davisim2/BP/KiCad_soubory/AS5304A.pdf

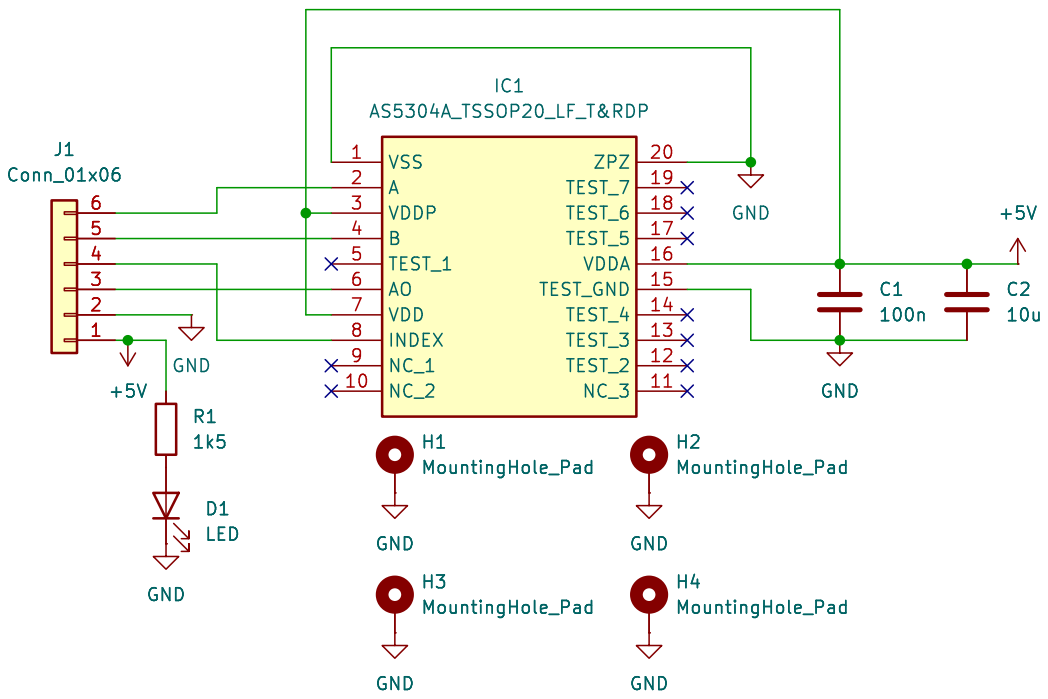
[picture p1: page 1]

Id: 1/1 Title: File: AS5304A.kicad_sch Sheet: / H4 MountingHole_Pad D1
