davisim2/BP/KiCad_soubory/BP Nerf Blaster.pdf

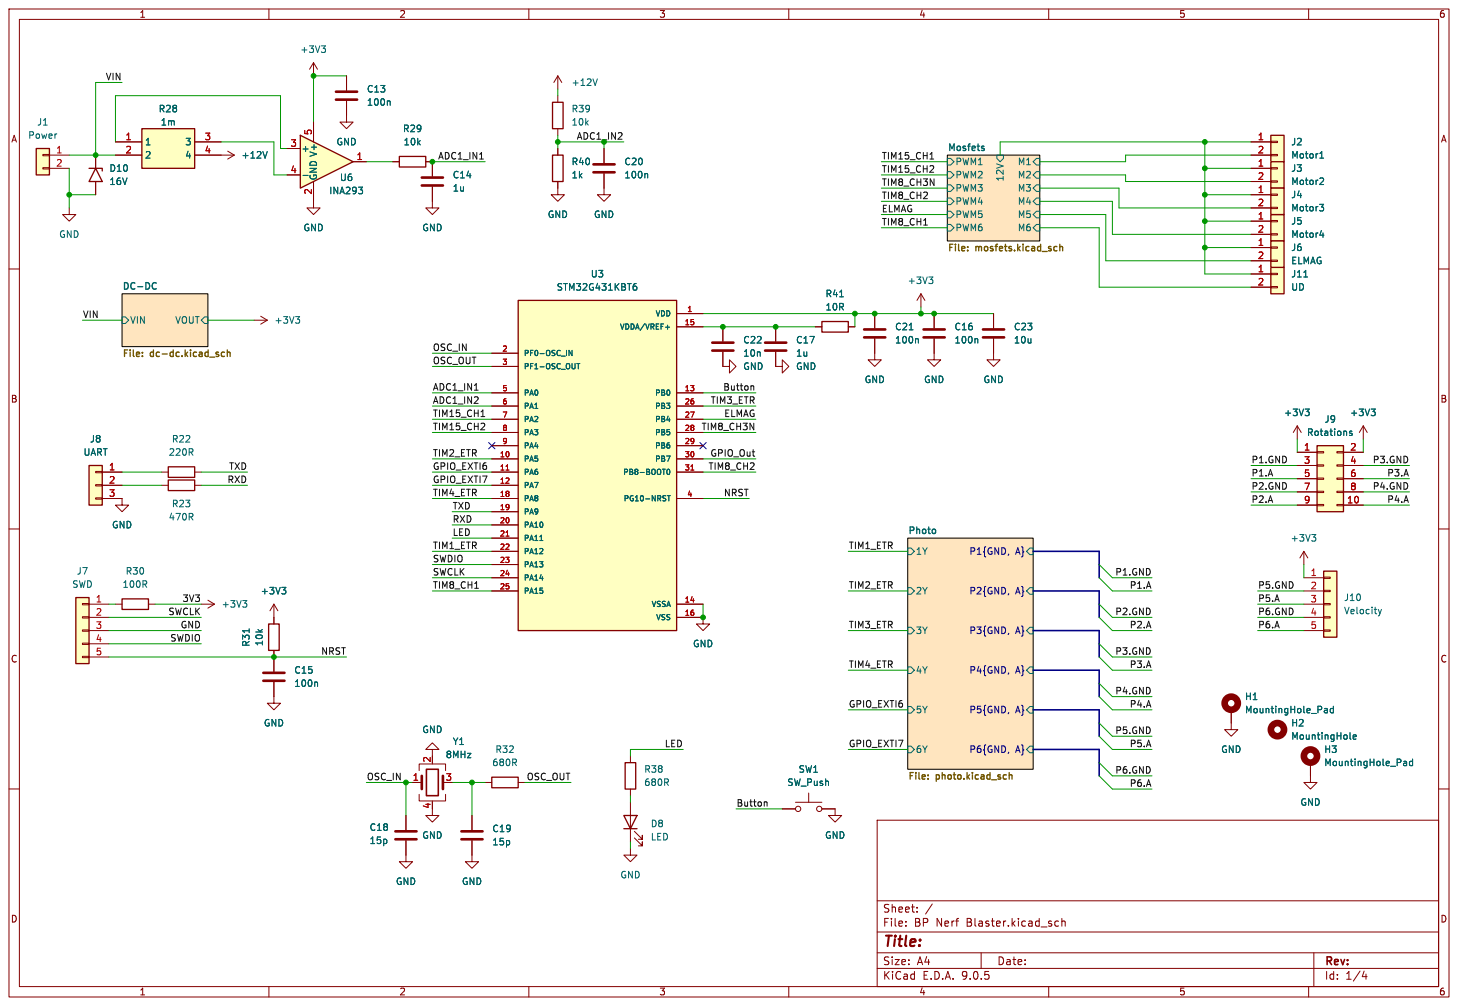
[picture p2: page 1]

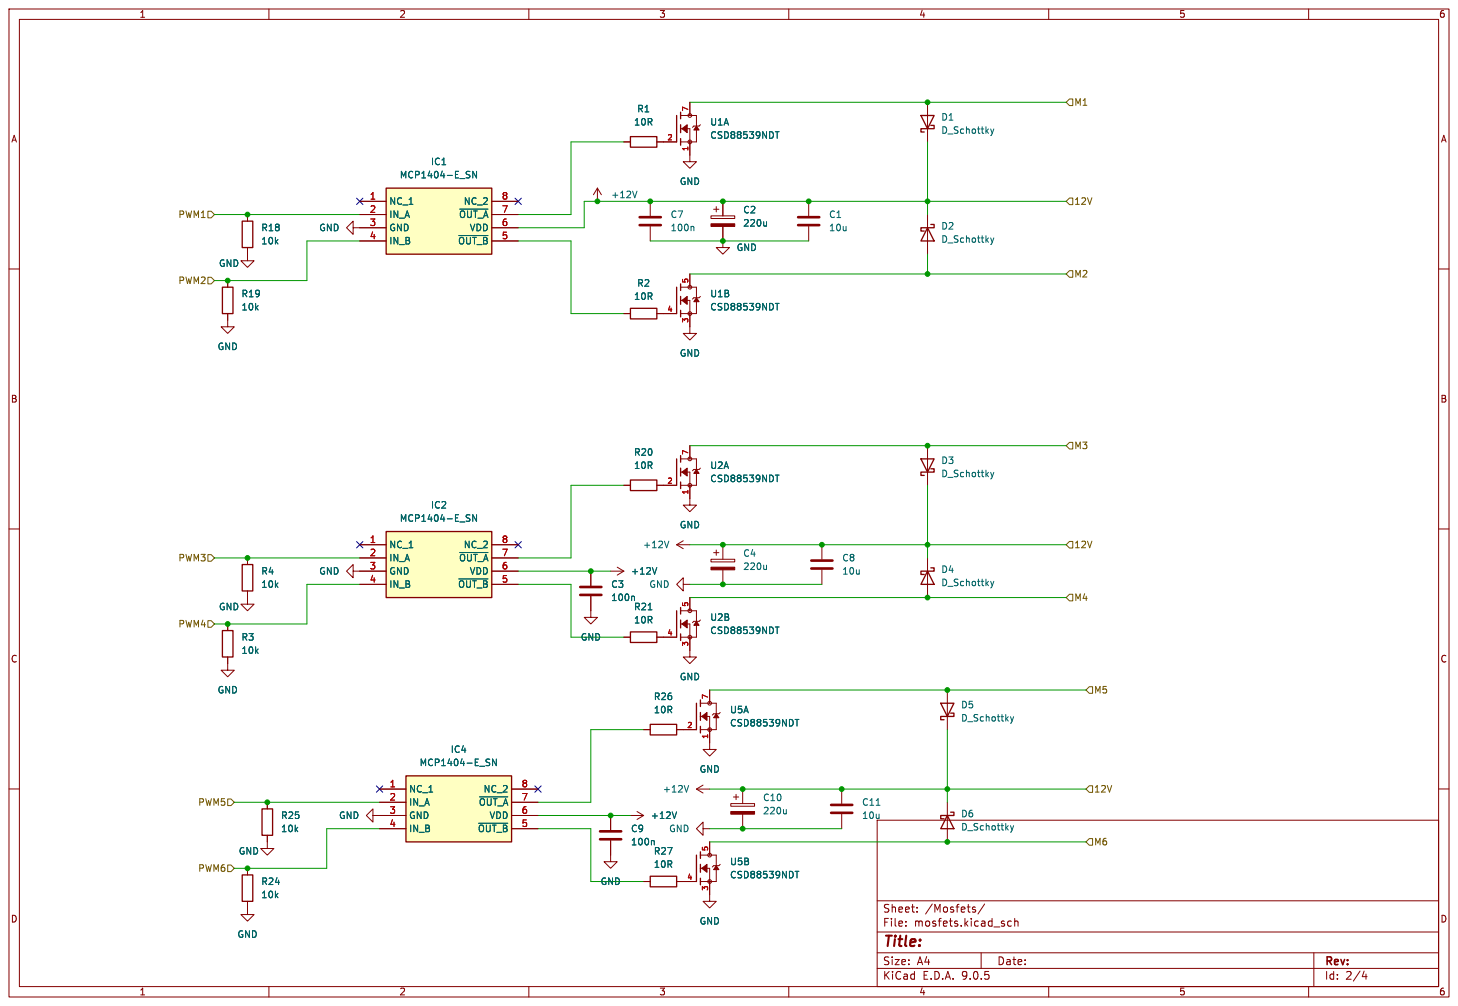
[picture p3: page 2]

Id: 2/4 Title: File: mosfets.kicad_sch Sheet: /Mosfets/ R26

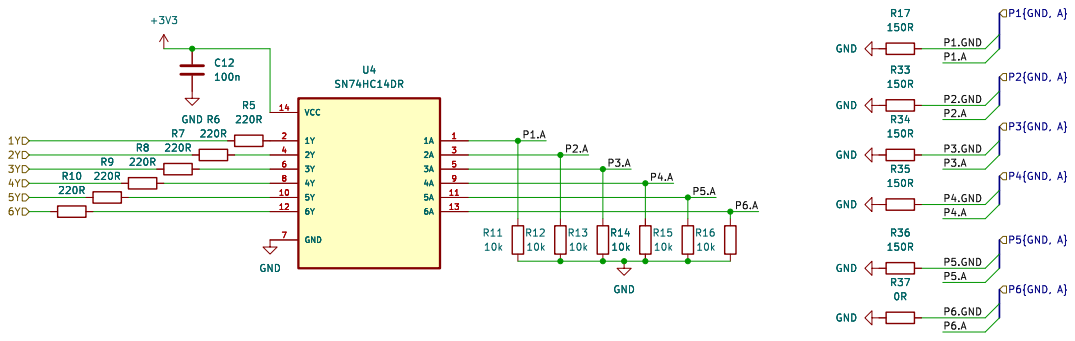
[picture p4: page 3]

Id: 3/4 Title: File: photo.kicad_sch Sheet: /Photo/

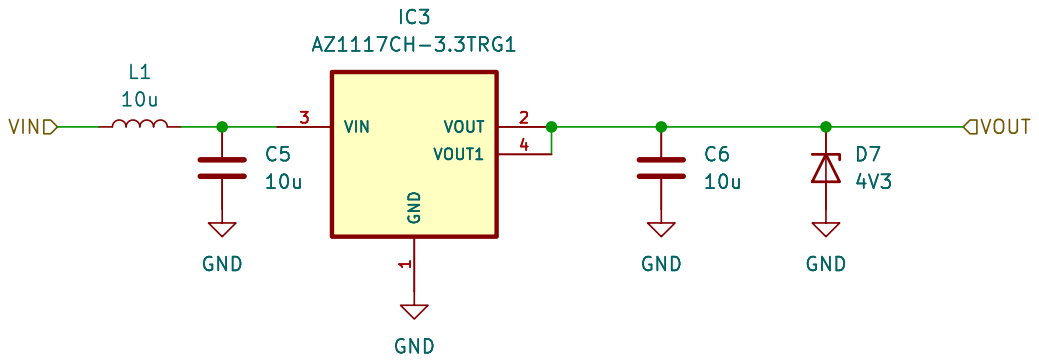
[picture p5: page 4]

Id: 4/4 Title: File: dc-dc.kicad_sch Sheet: /DC-DC/ GND
