davisim2/BP/KiCad_soubory/Fotodiody.pdf

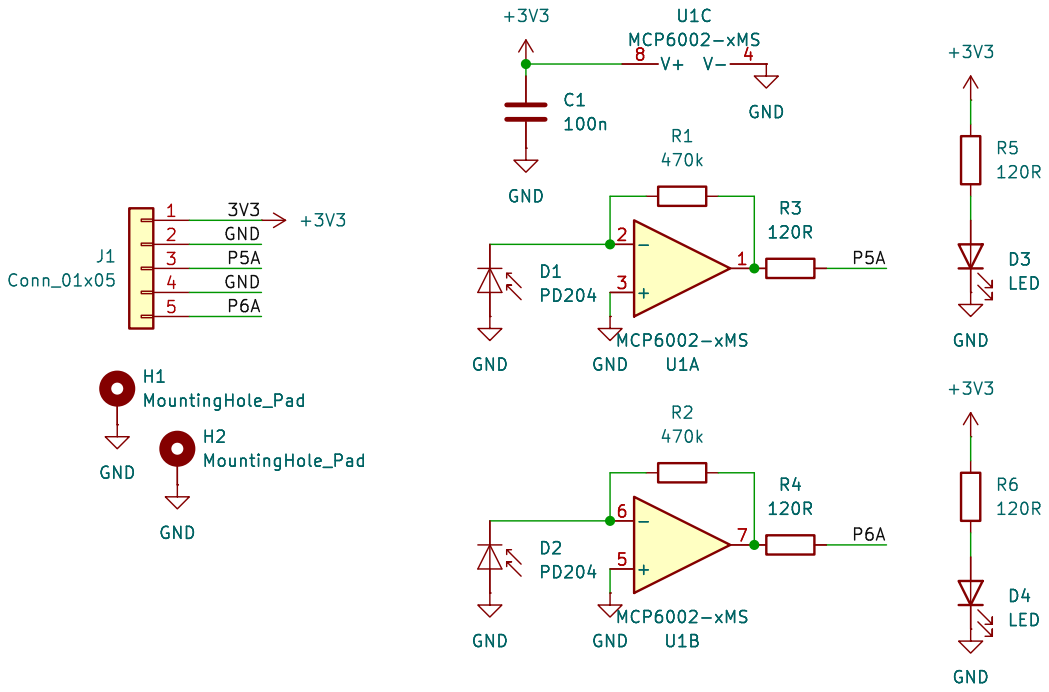
[picture p6: page 1]

Id: 1/1 Title: File: Fotodiody.kicad_sch Sheet: /
