davisim2/BP/KiCad_soubory/Řídící plošňák.pdf

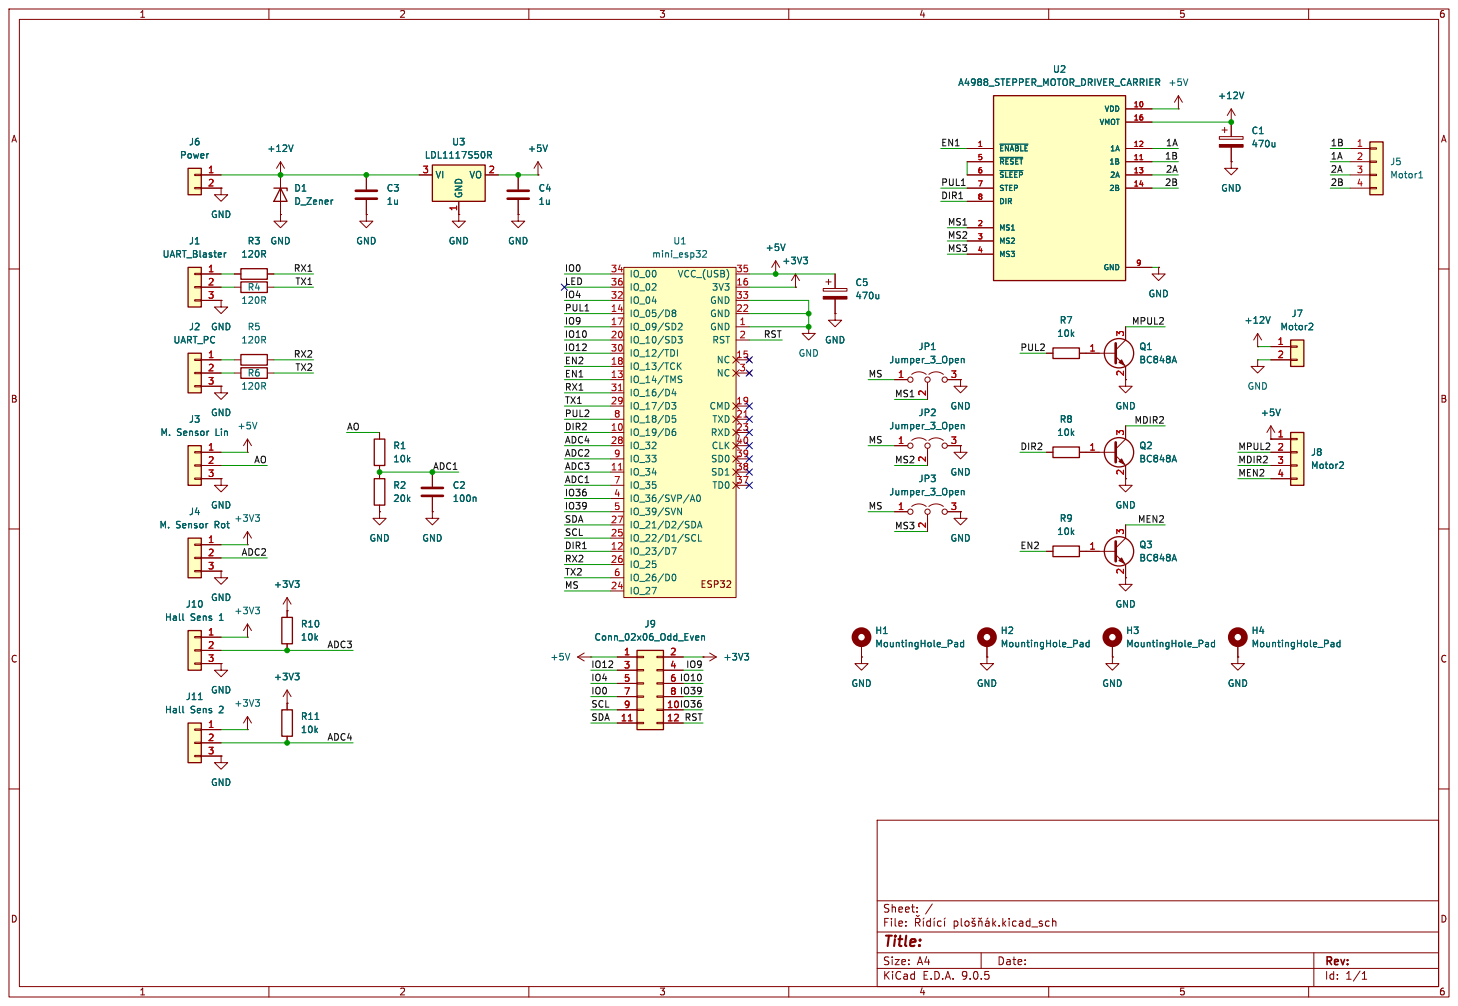
[picture p7: page 1]
