davisim2/BP/KiCad_soubory/BP Nerf Blaster/BP Nerf Blaster.kicad_pcb

## KiCad design KiCad_soubory/BP Nerf Blaster/BP Nerf Blaster.kicad_pcb (2026-05-22)

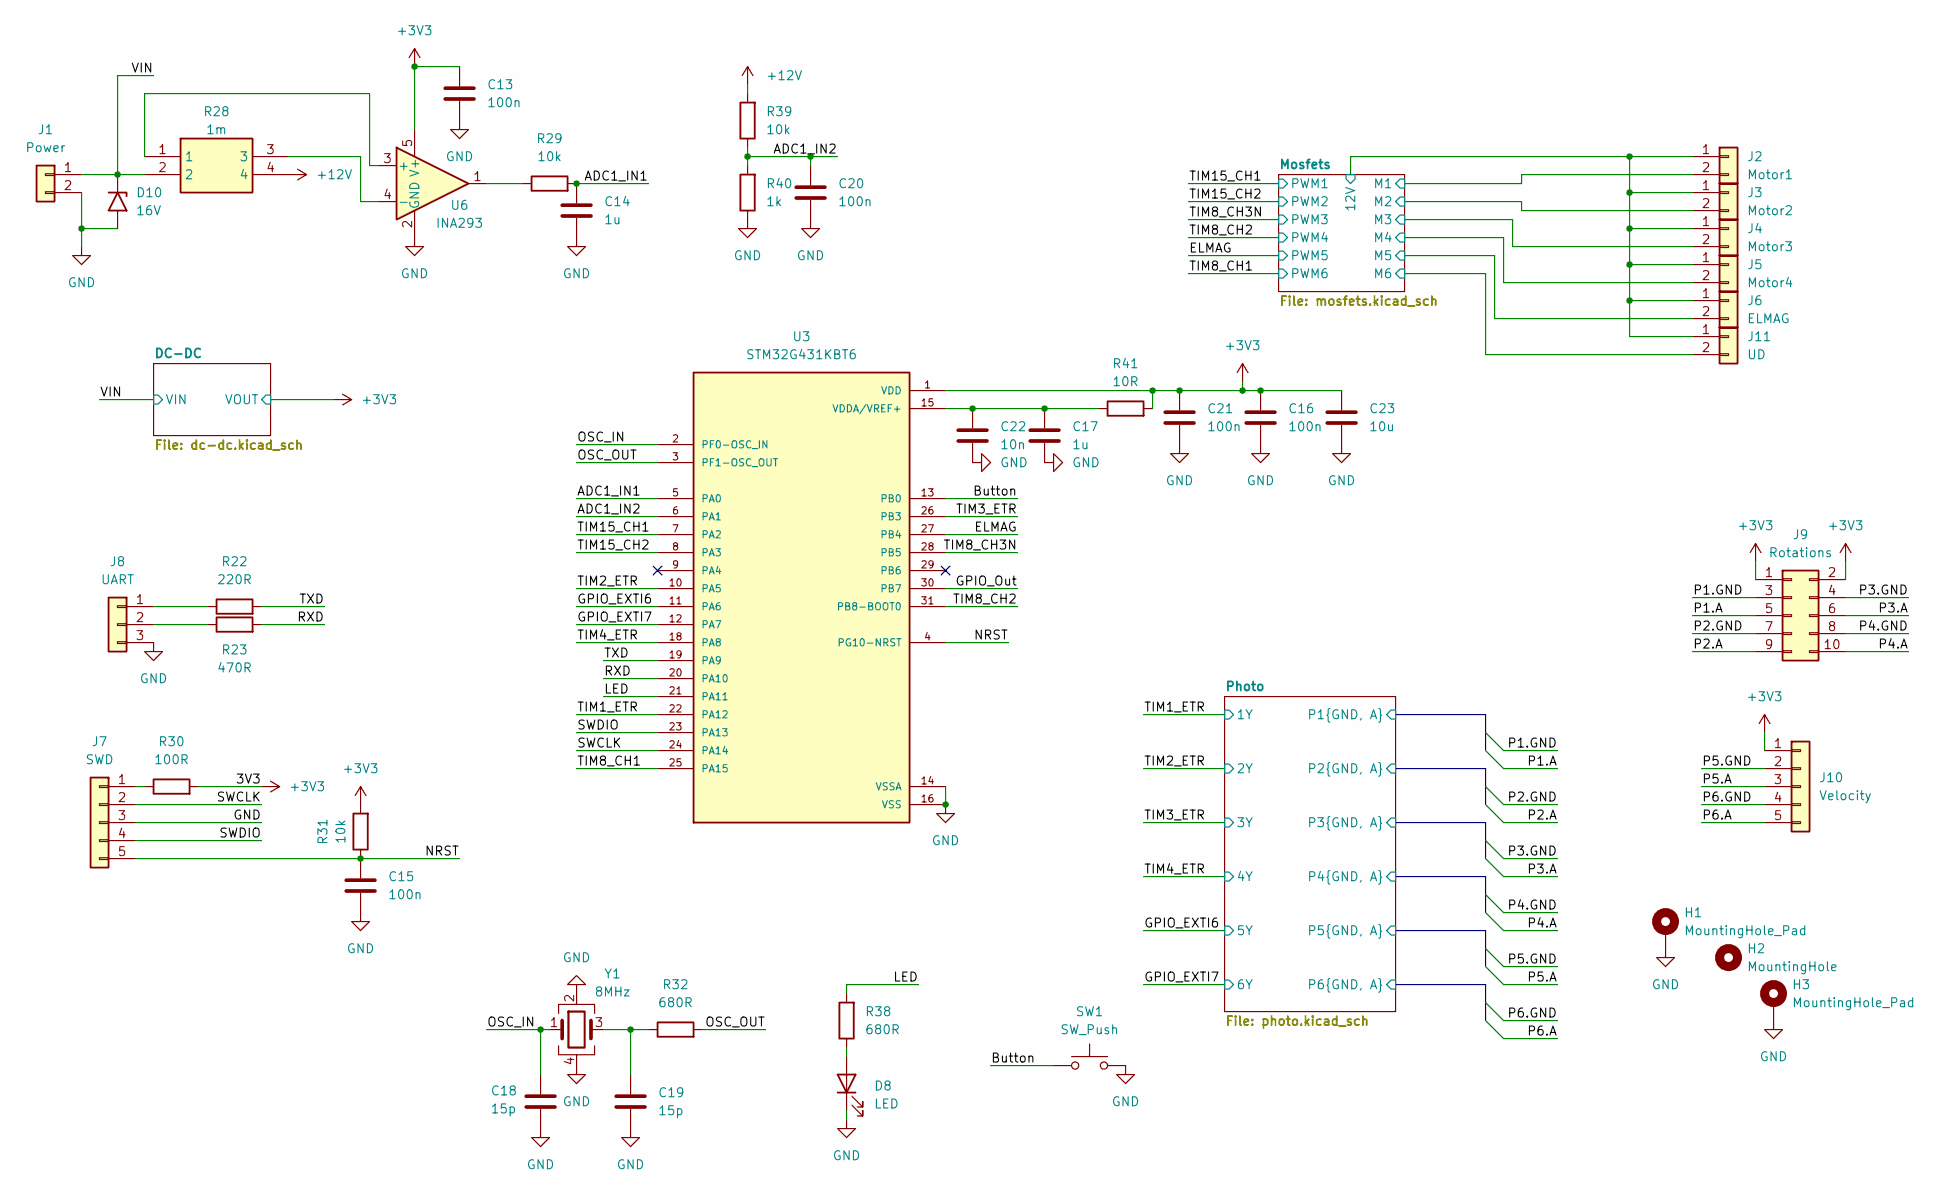
[picture p8: schematic BP Nerf Blaster.kicad_sch]

Parts:
C13, C15, C16, C20, C21: 100n; C_0805_2012Metric
C14, C17: 1u; C_0805_2012Metric
C18, C19: 15p; C_0805_2012Metric
C22: 10n; C_0603_1608Metric_Pad1.08x0.95mm_HandSolder
C23: 10u; C_0805_2012Metric
D8: LED; LED_D3.0mm
D10: 16V; D_SMB
H1, H3: MountingHole_Pad; MountingHole_3.2mm_M3_DIN965_Pad
H2: MountingHole; Hole
J1: Power; XT30-f
J2: Motor1; XT30-f
J3: Motor2; XT30-f
J4: Motor3; XT30-f
J5: Motor4; XT30-f
J6: ELMAG; XT30-f
J7: SWD; PinHeader_1x05_P1.27mm_Vertical
J8: UART; PinHeader_1x03_P2.54mm_Vertical
J9: Rotations; PinHeader_2x05_P2.54mm_Vertical
J10: Velocity; PinHeader_1x05_P2.54mm_Vertical
J11: UD; XT30-f
R22: 220R; R_0805_2012Metric
R23: 470R; R_0805_2012Metric
R28: 1m; WSK25121L000FEA; Mouser Part Number 71-WSK25121L000FEA
R29, R31, R39: 10k; R_0805_2012Metric
R30: 100R; R_0805_2012Metric
R32, R38: 680R; R_0805_2012Metric
R40: 1k; R_0805_2012Metric
R41: 10R; R_0805_2012Metric
SW1: SW_Push; SW_PUSH_6mm_H9.5mm
U3: STM32G431KBT6; QFP80P900X900X160-32N; PARTREV 2
U6: INA293; SOT-23-5
Y1: 8MHz; Crystal_SMD_SeikoEpson_FA238-4Pin_3.2x2.5mm

Connections:
+3V3: C13.1, C16.1, C21.1, C23.1, J9.1, J9.2, J10.1, R30.2, R31.2, R41.2, U3.1 (VDD), U3.17 (VDD), U6.5 (V+); also elsewhere on the board
+12V: J2.1, J3.1, J4.1, J5.1, J6.1, J11.1, R28.4, R39.2; also elsewhere on the board
/ADC1_IN1: C14.1, R29.2, U3.5 (PA0)
/ADC1_IN2: C20.1, R39.1, R40.2, U3.6 (PA1)
/Button: SW1.1, U3.13 (PB0)
/ELMAG: U3.27 (PB4); also elsewhere on the board
/GPIO_EXTI6: U3.11 (PA6); also elsewhere on the board
/GPIO_EXTI7: U3.12 (PA7); also elsewhere on the board
/GPIO_Out: U3.30 (PB7)
/LED: R38.2, U3.21 (PA11)
/Mosfets/M1: J2.2; also elsewhere on the board
/Mosfets/M2: J3.2; also elsewhere on the board
/Mosfets/M3: J4.2; also elsewhere on the board
/Mosfets/M4: J5.2; also elsewhere on the board
/Mosfets/M5: J6.2; also elsewhere on the board
/Mosfets/M6: J11.2; also elsewhere on the board
/NRST: C15.1, J7.5, R31.1, U3.4 (PG10-NRST)
/OSC_IN: C18.1, U3.2 (PF0-OSC_IN), Y1.1
/OSC_OUT: R32.2, U3.3 (PF1-OSC_OUT)
/Photo/P1.A: J9.5; also elsewhere on the board
/Photo/P1.GND: J9.3; also elsewhere on the board
/Photo/P2.A: J9.9; also elsewhere on the board
/Photo/P2.GND: J9.7; also elsewhere on the board
/Photo/P3.A: J9.6; also elsewhere on the board
/Photo/P3.GND: J9.4; also elsewhere on the board
/Photo/P4.A: J9.10; also elsewhere on the board
/Photo/P4.GND: J9.8; also elsewhere on the board
/Photo/P5.A: J10.3; also elsewhere on the board
/Photo/P5.GND: J10.2; also elsewhere on the board
/Photo/P6.A: J10.5; also elsewhere on the board
/RXD: R23.2, U3.20 (PA10)
/SWCLK: J7.2, U3.24 (PA14)
/SWDIO: J7.4, U3.23 (PA13)
/TIM1_ETR: U3.22 (PA12); also elsewhere on the board
/TIM2_ETR: U3.10 (PA5); also elsewhere on the board
/TIM3_ETR: U3.26 (PB3); also elsewhere on the board
/TIM4_ETR: U3.18 (PA8); also elsewhere on the board
/TIM8_CH1: U3.25 (PA15); also elsewhere on the board
/TIM8_CH2: U3.31 (PB8-BOOT0); also elsewhere on the board
/TIM8_CH3N: U3.28 (PB5); also elsewhere on the board
/TIM15_CH1: U3.7 (PA2); also elsewhere on the board
/TIM15_CH2: U3.8 (PA3); also elsewhere on the board
/TXD: R22.2, U3.19 (PA9)
/VIN: D10.1 (A1), J1.1, R28.2; also elsewhere on the board
unnamed: C19.1, R32.1, Y1.3
unnamed: D8.2 (A), R38.1
unnamed: J7.1, R30.1
unnamed: J8.1, R22.1
unnamed: J8.2, R23.1
unnamed: R29.1, U6.1
unnamed: C17.1, C22.1, R41.1, U3.15 (VDDA/VREF+)
unnamed: R28.1, U6.3 (+)
unnamed: R28.3, U6.4 (-)

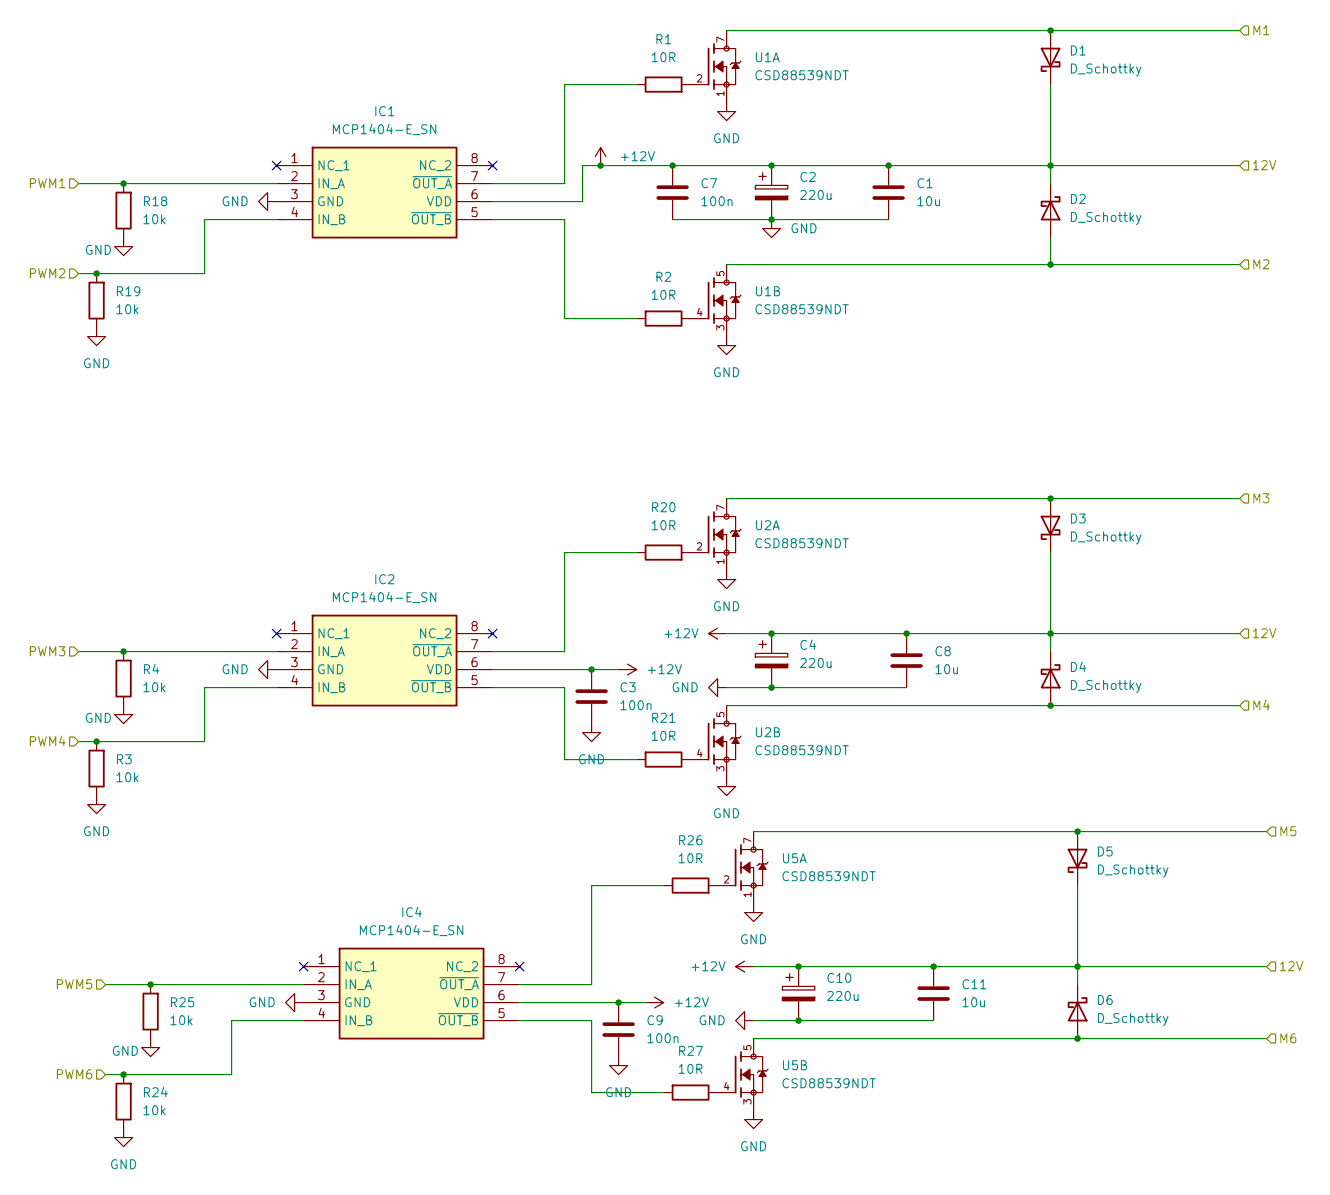
[picture p9: schematic mosfets.kicad_sch]

Parts:
C1, C8, C11: 10u; C_1206_3216Metric
C2, C4: 220u; C_Elec_8x10.2
C3, C7, C9: 100n; C_0805_2012Metric
C10: 220u; C_Elec_8x10.2; Mouser 80-EEV227M025A9MAA
D1: D_Schottky; D_SMA; Mouser 625-SSA34-E3
D2, D3, D4, D5, D6: D_Schottky; D_SMA
IC1, IC2, IC4: MCP1404-E_SN; SOIC127P600X175-8N; Mouser Part Number 579-MCP1404-E/SN
R1, R2, R20, R21, R26, R27: 10R; R_0805_2012Metric
R3, R4, R18, R19, R24, R25: 10k; R_0805_2012Metric
U1, U2, U5: CSD88539NDT; SOIC127P600X175-8N; PARTREV February 2014

Connections:
+12V: C1.1, C2.1, C3.1, C4.1, C7.1, C8.1, C9.1, C10.1, C11.1, D1.1 (K), D2.1 (K), D3.1 (K), D4.1 (K), D5.1 (K), D6.1 (K), IC1.6 (VDD), IC2.6 (VDD), IC4.6 (VDD); also elsewhere on the board
/ELMAG: IC4.2 (IN_A), R25.2; also elsewhere on the board
/Mosfets/M1: D1.2 (A), U1.7, U1.8; also elsewhere on the board
/Mosfets/M2: D2.2 (A), U1.5, U1.6; also elsewhere on the board
/Mosfets/M3: D3.2 (A), U2.7, U2.8; also elsewhere on the board
/Mosfets/M4: D4.2 (A), U2.5, U2.6; also elsewhere on the board
/Mosfets/M5: D5.2 (A), U5.7, U5.8; also elsewhere on the board
/Mosfets/M6: D6.2 (A), U5.5, U5.6; also elsewhere on the board
/TIM8_CH1: IC4.4 (IN_B), R24.2; also elsewhere on the board
/TIM8_CH2: IC2.4 (IN_B), R3.2; also elsewhere on the board
/TIM8_CH3N: IC2.2 (IN_A), R4.2; also elsewhere on the board
/TIM15_CH1: IC1.2 (IN_A), R18.2; also elsewhere on the board
/TIM15_CH2: IC1.4 (IN_B), R19.2; also elsewhere on the board
unnamed: IC1.7 (~OUT_A), R1.1
unnamed: IC1.5 (~OUT_B), R2.2
unnamed: IC2.7 (~OUT_A), R20.1
unnamed: IC2.5 (~OUT_B), R21.2
unnamed: IC4.7 (~OUT_A), R26.1
unnamed: IC4.5 (~OUT_B), R27.2
unnamed: R1.2, U1.2
unnamed: R2.1, U1.4
unnamed: R20.2, U2.2
unnamed: R21.1, U2.4
unnamed: R26.2, U5.2
unnamed: R27.1, U5.4

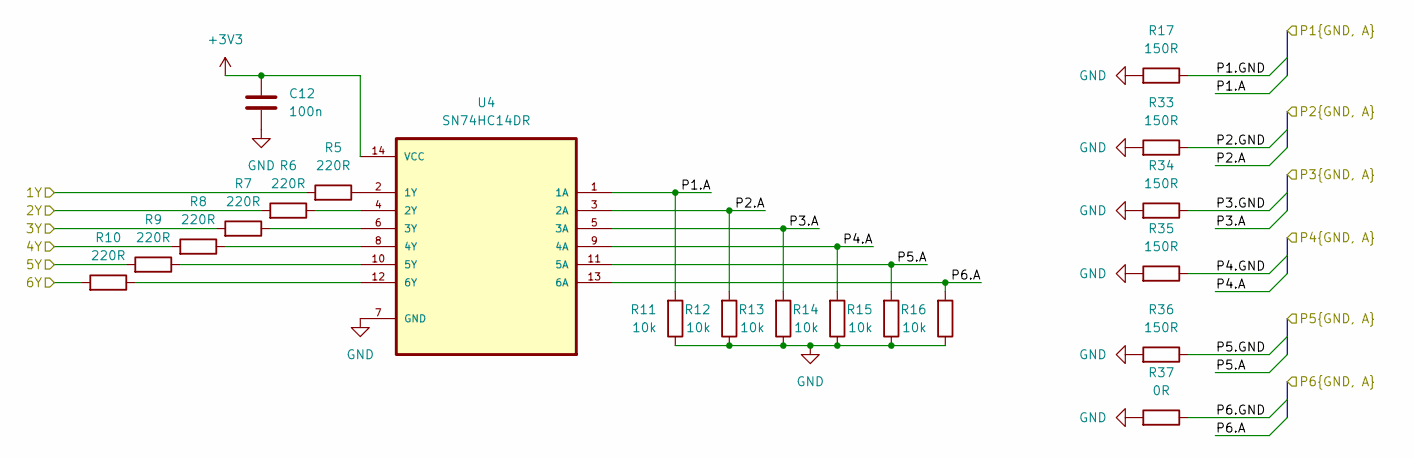
[picture p10: schematic photo.kicad_sch]

Parts:
C12: 100n; C_0805_2012Metric
R5, R6, R7, R8, R9, R10: 220R; R_0805_2012Metric
R11, R12, R13, R14, R15, R16: 10k; R_0805_2012Metric
R17, R33, R34, R35, R36: 150R; R_0805_2012Metric
R37: 0R; R_0805_2012Metric
U4: SN74HC14DR; SOIC127P600X175-14N

Connections:
+3V3: C12.1, U4.14 (VCC); also elsewhere on the board
/GPIO_EXTI6: R9.2; also elsewhere on the board
/GPIO_EXTI7: R10.2; also elsewhere on the board
/Photo/P1.A: R11.2, U4.1 (1A); also elsewhere on the board
/Photo/P1.GND: R17.1; also elsewhere on the board
/Photo/P2.A: R12.2, U4.3 (2A); also elsewhere on the board
/Photo/P2.GND: R33.1; also elsewhere on the board
/Photo/P3.A: R13.2, U4.5 (3A); also elsewhere on the board
/Photo/P3.GND: R34.1; also elsewhere on the board
/Photo/P4.A: R14.2, U4.9 (4A); also elsewhere on the board
/Photo/P4.GND: R35.1; also elsewhere on the board
/Photo/P5.A: R15.2, U4.11 (5A); also elsewhere on the board
/Photo/P5.GND: R36.1; also elsewhere on the board
/Photo/P6.A: R16.2, U4.13 (6A); also elsewhere on the board
/Photo/P6.GND: R37.1
/TIM1_ETR: R5.2; also elsewhere on the board
/TIM2_ETR: R6.2; also elsewhere on the board
/TIM3_ETR: R7.2; also elsewhere on the board
/TIM4_ETR: R8.2; also elsewhere on the board
unnamed: R5.1, U4.2 (1Y)
unnamed: R6.1, U4.4 (2Y)
unnamed: R7.1, U4.6 (3Y)
unnamed: R8.1, U4.8 (4Y)
unnamed: R9.1, U4.10 (5Y)
unnamed: R10.1, U4.12 (6Y)

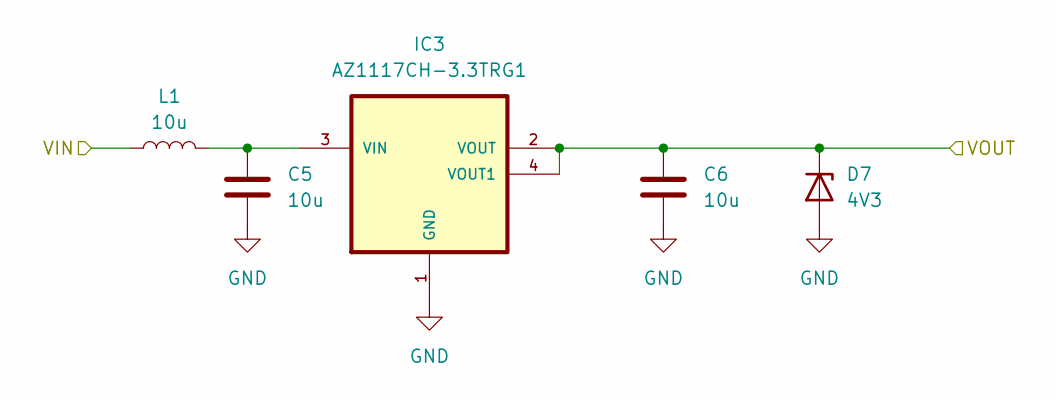
[picture p11: schematic dc-dc.kicad_sch]

Parts:
C5, C6: 10u; C_1206_3216Metric
D7: 4V3; D_SMA
IC3: AZ1117CH-3.3TRG1; SOT223
L1: 10u; L_0805_2012Metric

Connections:
+3V3: C6.1, D7.1 (K), IC3.2 (VOUT), IC3.4 (VOUT1); also elsewhere on the board
/VIN: L1.1; also elsewhere on the board
unnamed: C5.1, IC3.3 (VIN), L1.2

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
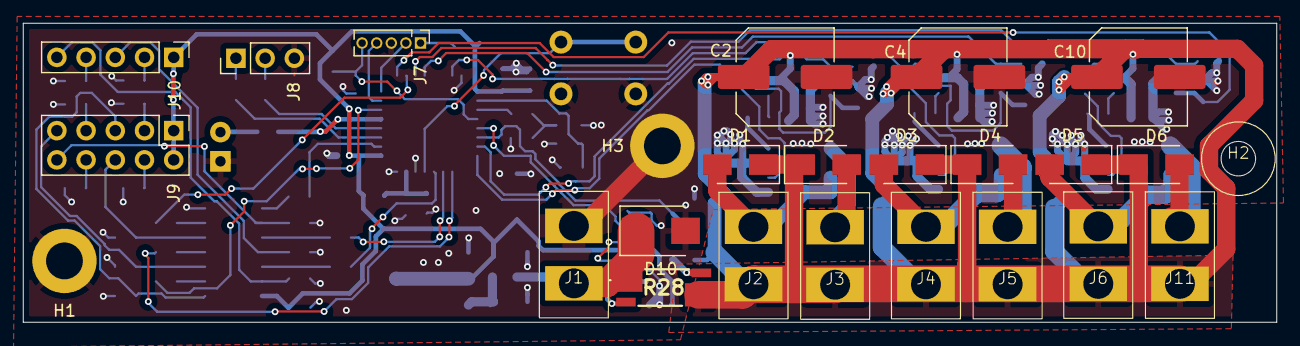
[picture p12: board BP Nerf Blaster.kicad_pcb from above]

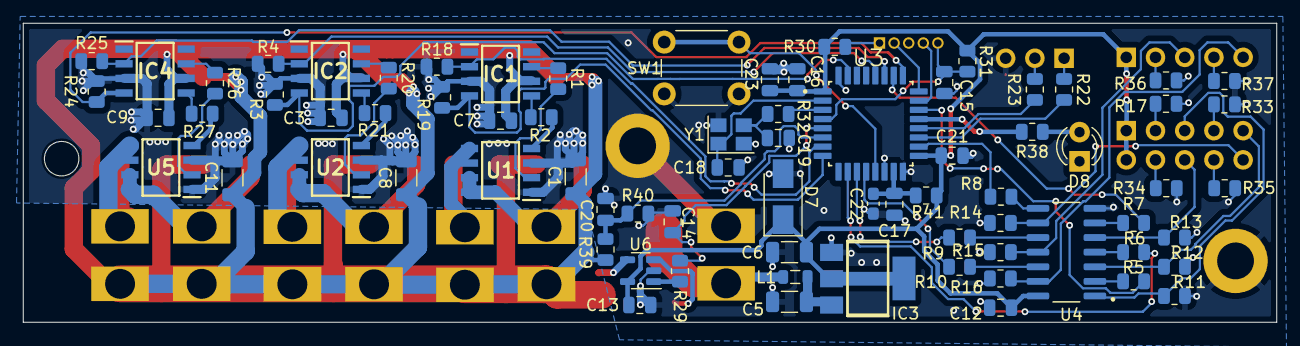
[picture p13: board BP Nerf Blaster.kicad_pcb from below]

Board: 2 copper layers, 109.0 x 26.0 mm, 100 parts (75 on the bottom side), 72 nets.
