davisim2/BP/KiCad_soubory/Řídící plošňák/Řídící plošňák.kicad_pcb

## KiCad design KiCad_soubory/Řídící plošňák/Řídící plošňák.kicad_pcb (2026-05-22)

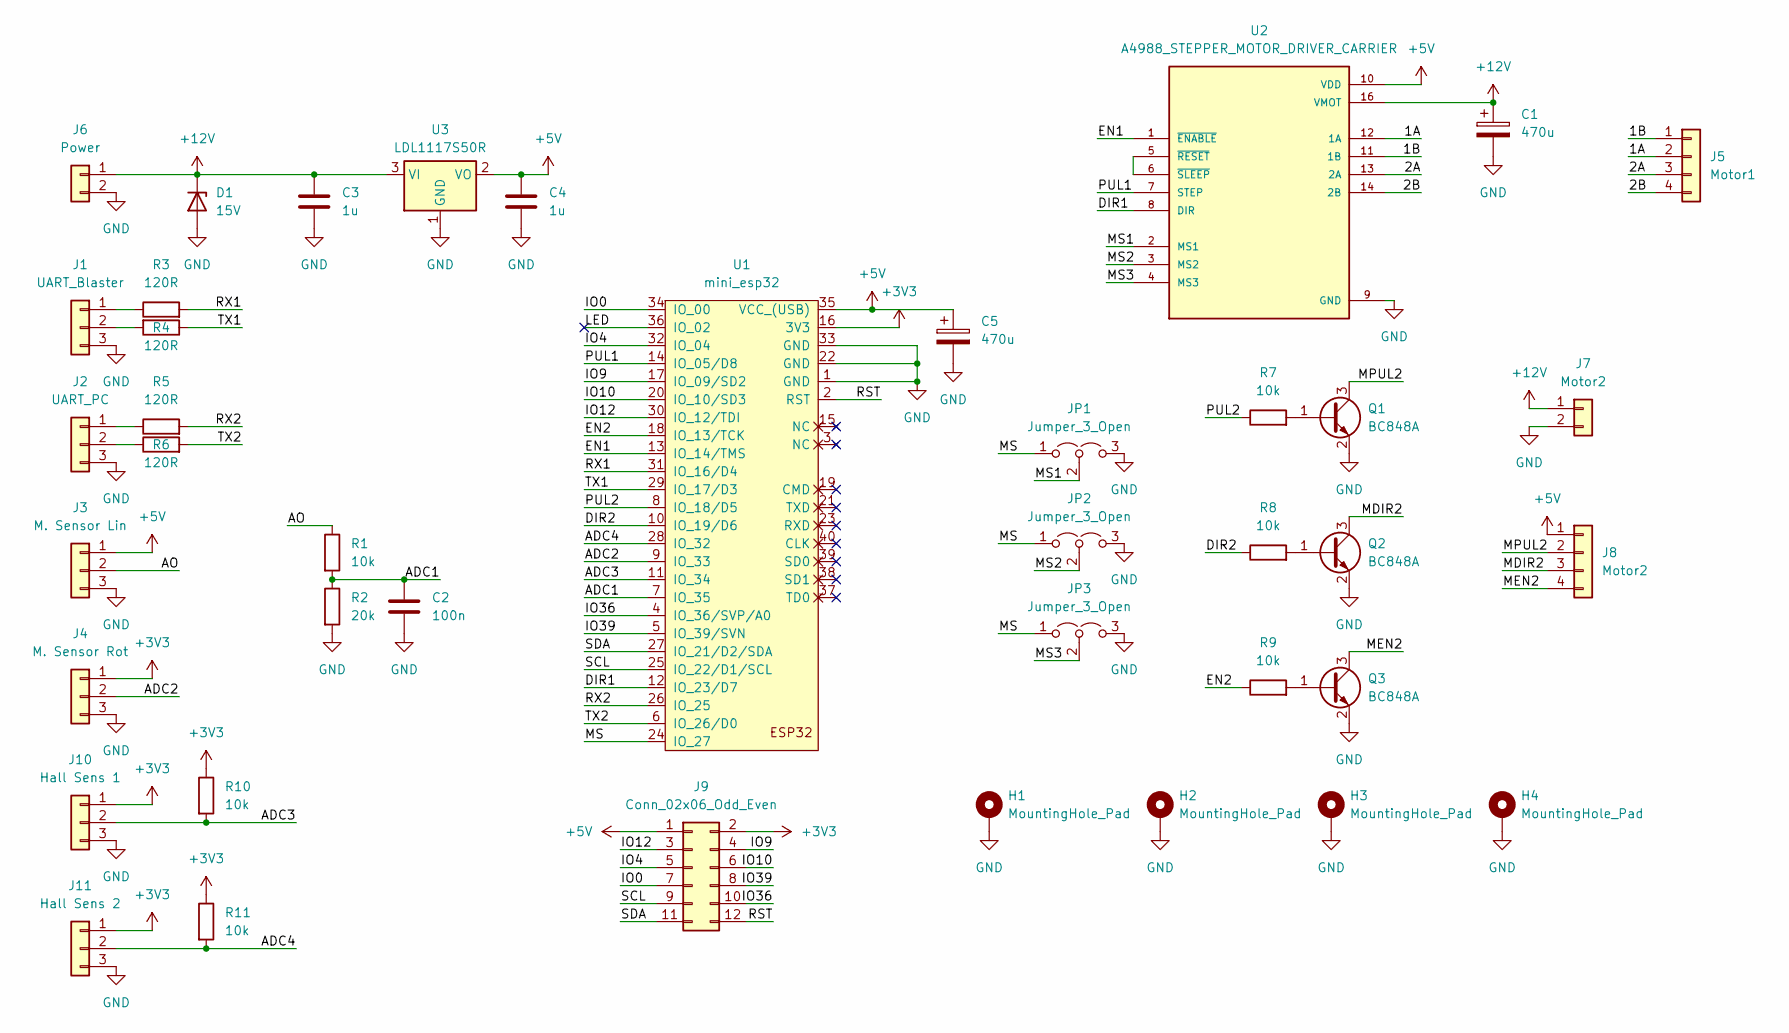
[picture p14: schematic Řídící plošňák.kicad_sch]

Parts:
C1, C5: 470u; CP_Elec_8x10
C2: 100n; C_1206_3216Metric_Pad1.33x1.80mm_HandSolder
C3, C4: 1u; C_1206_3216Metric_Pad1.33x1.80mm_HandSolder
D1: 15V; D_SMB_Handsoldering
H1, H2, H3, H4: MountingHole_Pad; MountingHole_4.3mm_M4_DIN965_Pad
J1: UART_Blaster; PinHeader_1x03_P2.54mm_Vertical
J2: UART_PC; PinHeader_1x03_P2.54mm_Vertical
J3: M. Sensor Lin; PinHeader_1x03_P2.54mm_Vertical
J4: M. Sensor Rot; PinHeader_1x03_P2.54mm_Vertical
J5: Motor1; TE_282822-4
J6: Power; XT30-f
J7: Motor2; XT30-f
J8: Motor2; PinHeader_1x04_P2.54mm_Vertical
J9: Conn_02x06_Odd_Even; PinHeader_2x06_P2.54mm_Vertical
J10: Hall Sens 1; PinHeader_1x03_P2.54mm_Vertical
J11: Hall Sens 2; PinHeader_1x03_P2.54mm_Vertical
JP1, JP2, JP3: Jumper_3_Open; SolderJumper-3_P1.3mm_Open_Pad1.0x1.5mm_NumberLabels
Q1, Q2, Q3: BC848A; SOT-23_Handsoldering
R1, R7, R8, R9, R10, R11: 10k; R_1206_3216Metric_Pad1.30x1.75mm_HandSolder
R2: 20k; R_1206_3216Metric_Pad1.30x1.75mm_HandSolder
R3, R4, R5, R6: 120R; R_1206_3216Metric_Pad1.30x1.75mm_HandSolder
U1: mini_esp32; ESP32_mini
U2: A4988_STEPPER_MOTOR_DRIVER_CARRIER; MODULE_A4988_STEPPER_MOTOR_DRIVER_CARRIER
U3: LDL1117S50R; SOT-223-3_TabPin2

Connections:
+3V3: J4.1, J9.2, J10.1, J11.1, R10.1, R11.1, U1.16 (3V3)
+5V: C4.1, C5.1, J3.1, J8.1, J9.1, U1.35 (VCC_(USB)), U2.10 (VDD), U3.2 (VO)
+12V: C1.1, C3.1, D1.1 (K), J6.1, J7.1, U2.16 (VMOT), U3.3 (VI)
/1A: J5.2, U2.12 (1A)
/1B: J5.1, U2.11 (1B)
/2A: J5.3, U2.13 (2A)
/2B: J5.4, U2.14 (2B)
/ADC1: C2.1, R1.2, R2.1, U1.7 (IO_35)
/ADC2: J4.2, U1.9 (IO_33)
/ADC3: J10.2, R10.2, U1.11 (IO_34)
/ADC4: J11.2, R11.2, U1.28 (IO_32)
/AO: J3.2, R1.1
/DIR1: U1.12 (IO_23/D7), U2.8 (DIR)
/DIR2: R8.1, U1.10 (IO_19/D6)
/EN1: U1.13 (IO_14/TMS), U2.1 (~ENABLE)
/EN2: R9.1, U1.18 (IO_13/TCK)
/IO0: J9.7, U1.34 (IO_00)
/IO4: J9.5, U1.32 (IO_04)
/IO9: J9.4, U1.17 (IO_09/SD2)
/IO10: J9.6, U1.20 (IO_10/SD3)
/IO12: J9.3, U1.30 (IO_12/TDI)
/IO36: J9.10, U1.4 (IO_36/SVP/A0)
/IO39: J9.8, U1.5 (IO_39/SVN)
/LED: U1.36 (IO_02)
/MDIR2: J8.3, Q2.3 (C)
/MEN2: J8.4, Q3.3 (C)
/MPUL2: J8.2, Q1.3 (C)
/MS: JP1.1 (A), JP2.1 (A), JP3.1 (A), U1.24 (IO_27)
/MS1: JP1.2 (C), U2.2 (MS1)
/MS2: JP2.2 (C), U2.3 (MS2)
/MS3: JP3.2 (C), U2.4 (MS3)
/PUL1: U1.14 (IO_05/D8), U2.7 (STEP)
/PUL2: R7.1, U1.8 (IO_18/D5)
/RST: J9.12, U1.2 (RST)
/RX1: R3.2, U1.31 (IO_16/D4)
/RX2: R5.2, U1.26 (IO_25)
/SCL: J9.9, U1.25 (IO_22/D1/SCL)
/SDA: J9.11, U1.27 (IO_21/D2/SDA)
/TX1: R4.1, U1.29 (IO_17/D3)
/TX2: R6.2, U1.6 (IO_26/D0)
GND: C1.2, C2.2, C3.2, C4.2, C5.2, D1.2 (A), H1.1, H2.1, H3.1, H4.1, J1.3, J2.3, J3.3, J4.3, J6.2, J7.2, J10.3, J11.3, JP1.3 (B), JP2.3 (B), JP3.3 (B), Q1.2 (E), Q2.2 (E), Q3.2 (E), R2.2, U1.1 (GND), U1.22 (GND), U1.33 (GND), U2.9 (GND), U2.15 (GND), U3.1 (GND)
unnamed: J1.1, R3.1
unnamed: J1.2, R4.2
unnamed: J2.1, R5.1
unnamed: J2.2, R6.1
unnamed: Q1.1 (B), R7.2
unnamed: Q2.1 (B), R8.2
unnamed: Q3.1 (B), R9.2
unnamed: U2.5 (~RESET), U2.6 (~SLEEP)

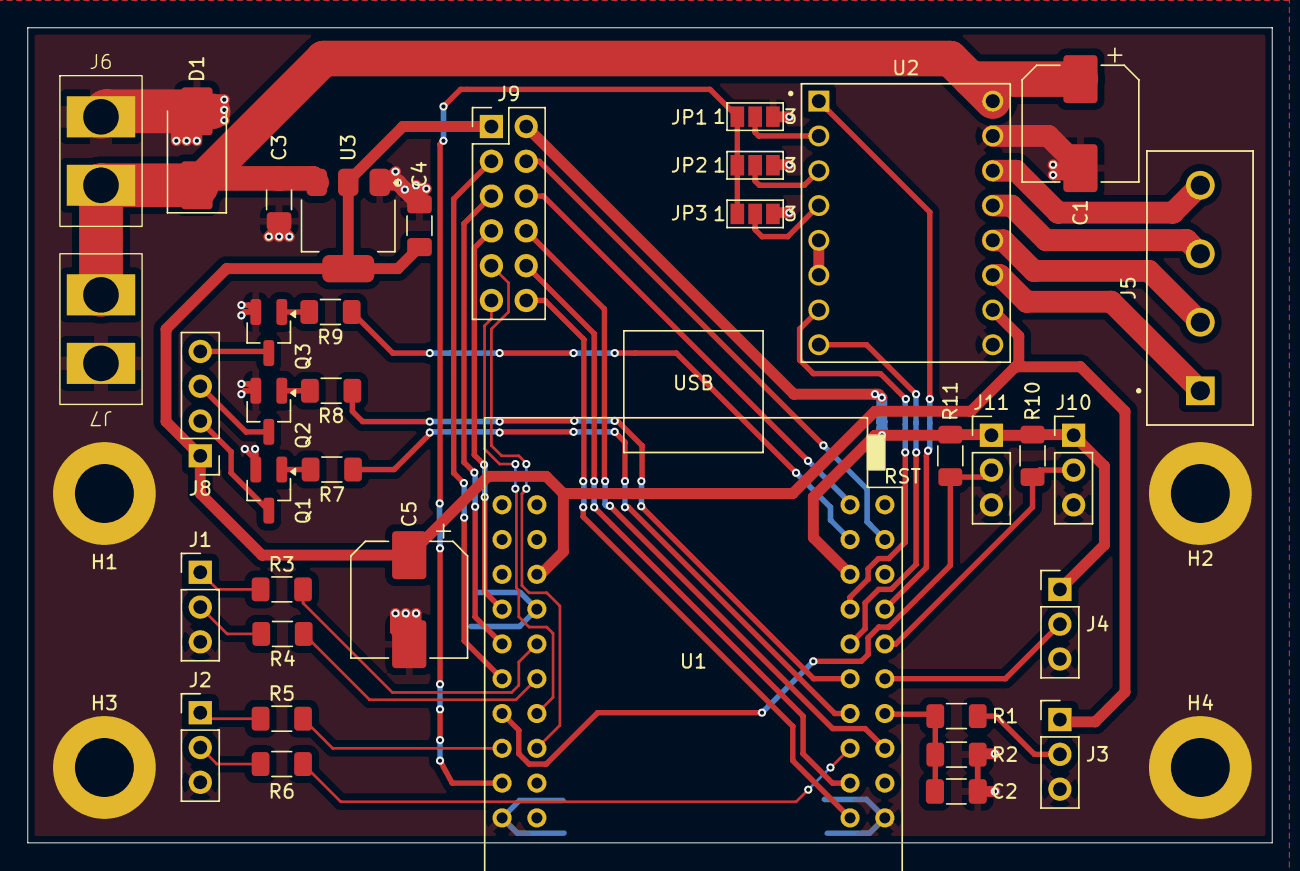
[picture p15: board Řídící plošňák.kicad_pcb from above]

Board: 2 copper layers, 90.8 x 59.5 mm, 41 parts (0 on the bottom side), 48 nets.
