davisim2/BP/KiCad_soubory/AS5304A/AS5304A.kicad_pcb

## KiCad design KiCad_soubory/AS5304A/AS5304A.kicad_pcb (2026-05-22)

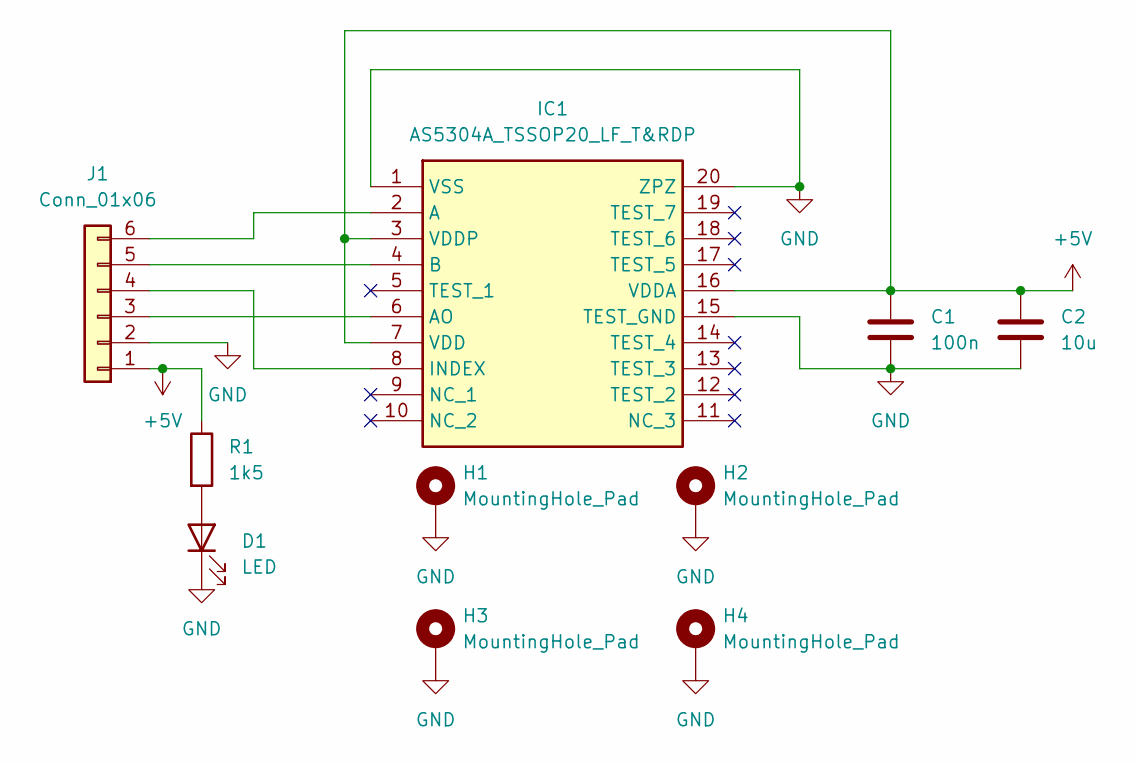
[picture p16: schematic AS5304A.kicad_sch]

Parts:
C1: 100n; C_0805_2012Metric_Pad1.18x1.45mm_HandSolder
C2: 10u; C_1206_3216Metric_Pad1.33x1.80mm_HandSolder
D1: LED; LED_1206_3216Metric_Pad1.42x1.75mm_HandSolder
H1, H2, H3, H4: MountingHole_Pad; MountingHole_3.2mm_M3_DIN965_Pad
IC1: AS5304A_TSSOP20_LF_T&RDP; SOP65P640X120-20N; Mouser Part Number 985-AS5304A-ATSM
J1: Conn_01x06; PinHeader_1x06_P2.54mm_Vertical
R1: 1k5; R_1206_3216Metric_Pad1.30x1.75mm_HandSolder

Connections:
+5V: C1.1, C2.1, IC1.3 (VDDP), IC1.7 (VDD), IC1.16 (VDDA), J1.1, R1.1
GND: C1.2, C2.2, D1.1 (K), H1.1, H2.1, H3.1, H4.1, IC1.1 (VSS), IC1.15 (TEST_GND), IC1.20 (ZPZ), J1.2
unnamed: D1.2 (A), R1.2
unnamed: IC1.2 (A), J1.6
unnamed: IC1.6 (AO), J1.3
unnamed: IC1.4 (B), J1.5
unnamed: IC1.8 (INDEX), J1.4

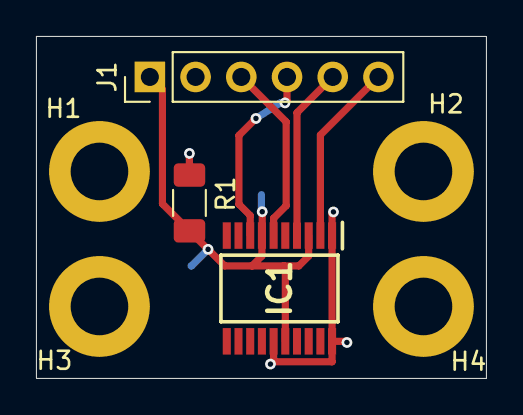
[picture p17: board AS5304A.kicad_pcb from above]

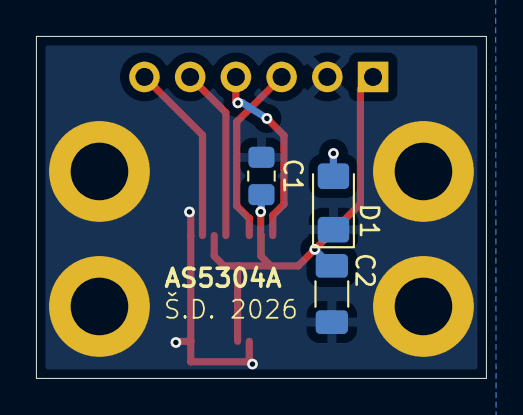
[picture p18: board AS5304A.kicad_pcb from below]

Board: 2 copper layers, 25.0 x 19.0 mm, 10 parts (3 on the bottom side), 7 nets.
