davisim2/BP/KiCad_soubory/Fotodiody/Fotodiody.kicad_pcb

## KiCad design KiCad_soubory/Fotodiody/Fotodiody.kicad_pcb (2026-05-22)

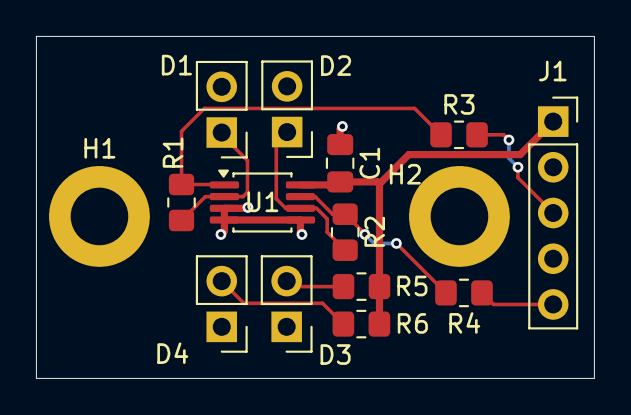
[picture p19: board Fotodiody.kicad_pcb from above]

Board: 2 copper layers, 31.0 x 19.0 mm, 15 parts (0 on the bottom side), 10 nets.

Parts:
C1: 100n; C_0805_2012Metric_Pad1.18x1.45mm_HandSolder
D1, D2: PD204; PinHeader_1x02_P2.54mm_Vertical
D3, D4: LED; PinHeader_1x02_P2.54mm_Vertical
H1, H2: MountingHole_Pad; MountingHole_3.2mm_M3_DIN965_Pad
J1: Conn_01x05; PinSocket_1x05_P2.54mm_Vertical
R1, R2: 470k; R_0805_2012Metric_Pad1.20x1.40mm_HandSolder
R3, R4: 120R; R_0805_2012Metric_Pad1.20x1.40mm_HandSolder
R5, R6: 130; R_0805_2012Metric_Pad1.20x1.40mm_HandSolder
U1: MCP6002-xMS; MSOP-8_3x3mm_P0.65mm

Connections:
+3V3: C1.2, J1.1, R5.2, R6.2, U1.8 (V+)
/P5A: J1.3, R3.2
/P6A: J1.5, R4.2
GND: C1.1, D1.2 (K), D2.2 (K), D3.1 (K), D4.1 (K), H1.1, H2.1, J1.2, J1.4, U1.3 (+), U1.4 (V-), U1.5 (+)
unnamed: D1.1 (A), R1.1, U1.2 (-)
unnamed: D2.1 (A), R2.1, U1.6 (-)
unnamed: D3.2 (A), R5.1
unnamed: D4.2 (A), R6.1
unnamed: R1.2, R3.1, U1.1
unnamed: R2.2, R4.1, U1.7
